GrumpyKit10/Wildfire-Detection-System/Documentation/Media/IMG_20230428_120932731.jpg

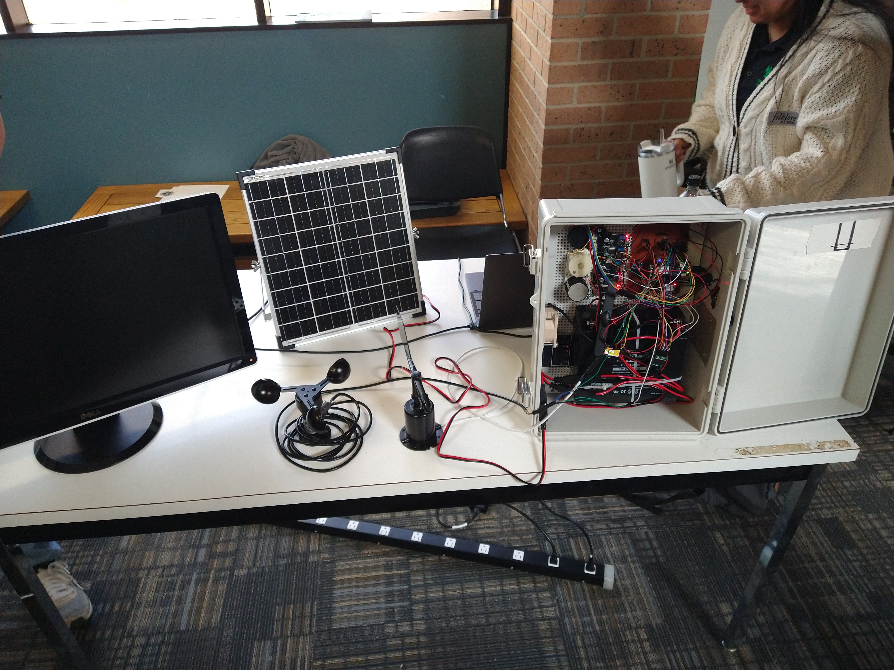
Documentation/Media/IMG_20230428_120932731.jpg
