GrumpyKit10/Wildfire-Detection-System/Documentation/Media/IMG_5393.jpg

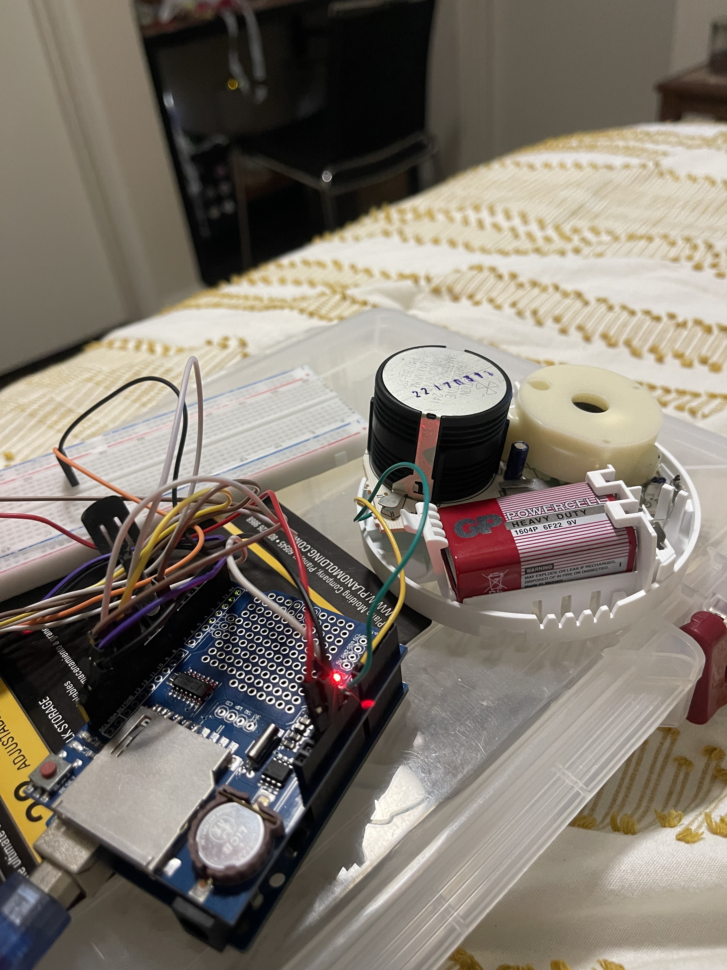
Documentation/Media/IMG_5393.jpg
