GrumpyKit10/Wildfire-Detection-System/Documentation/Media/20221214_185445.jpg

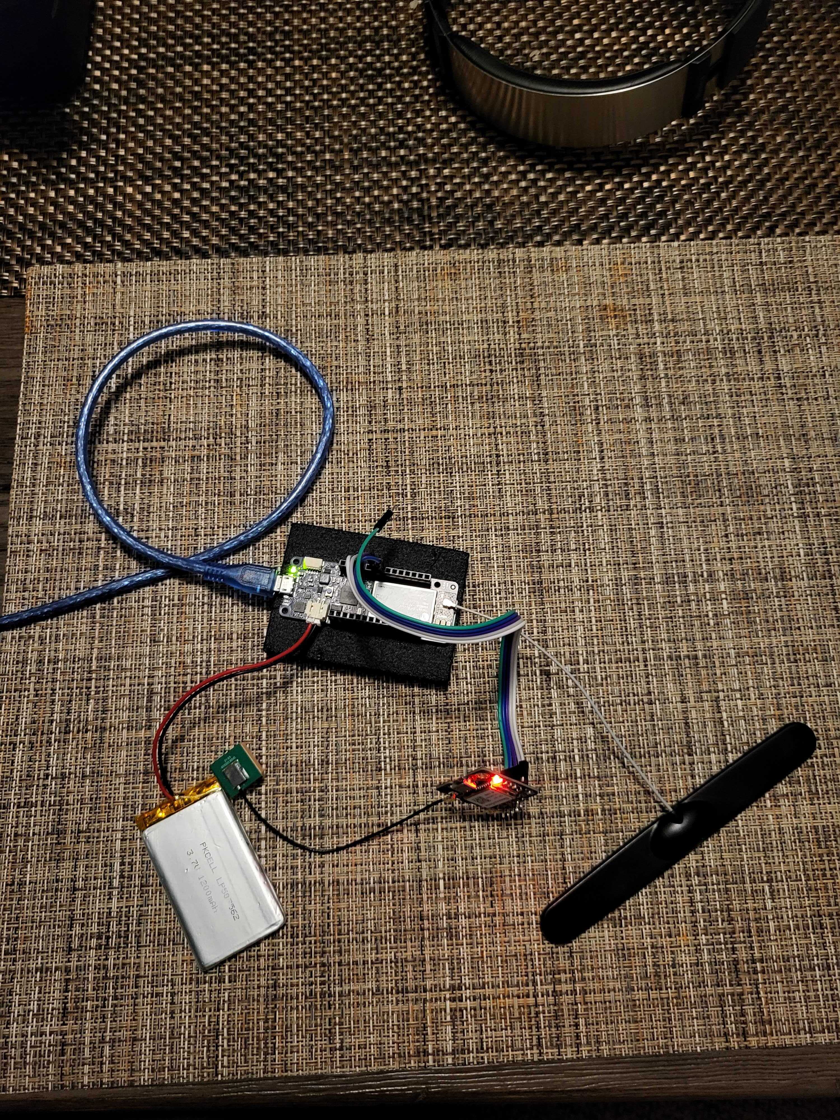
Documentation/Media/20221214_185445.jpg
