GrumpyKit10/Wildfire-Detection-System/Documentation/Media/IMG_5392.jpg

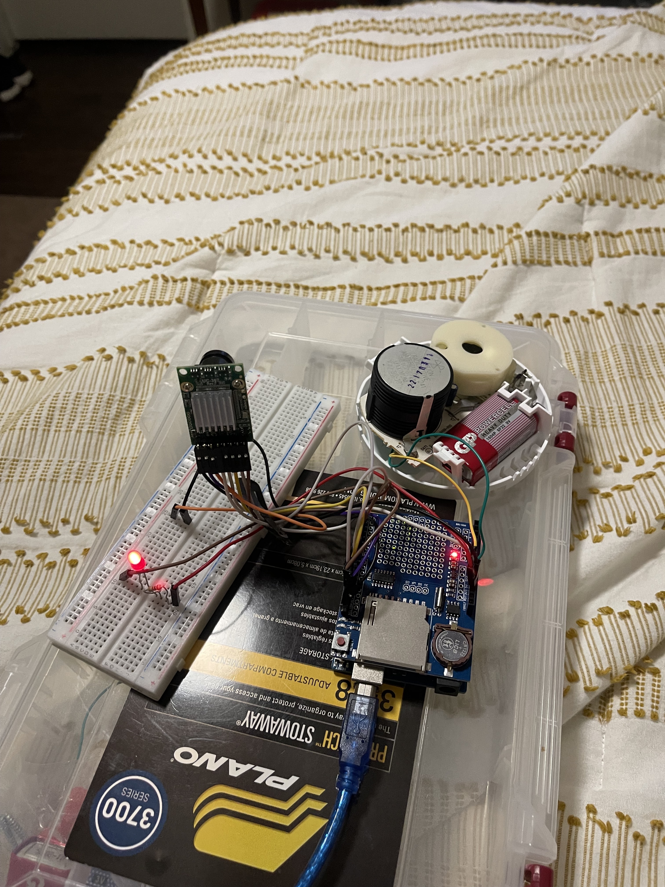
Documentation/Media/IMG_5392.jpg
