GrumpyKit10/Wildfire-Detection-System/Documentation/Media/IMG_20230406_163446074.jpg

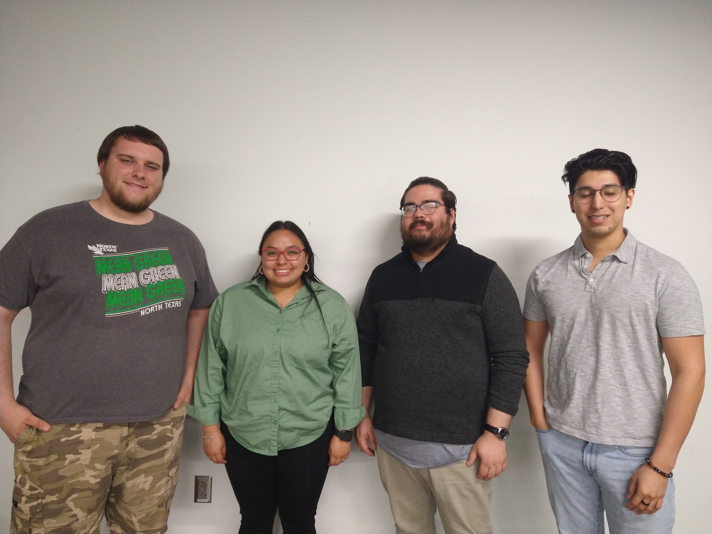
Documentation/Media/IMG_20230406_163446074.jpg
