GrumpyKit10/Wildfire-Detection-System/Documentation/Media/IMG_20230428_121048171_HDR.jpg

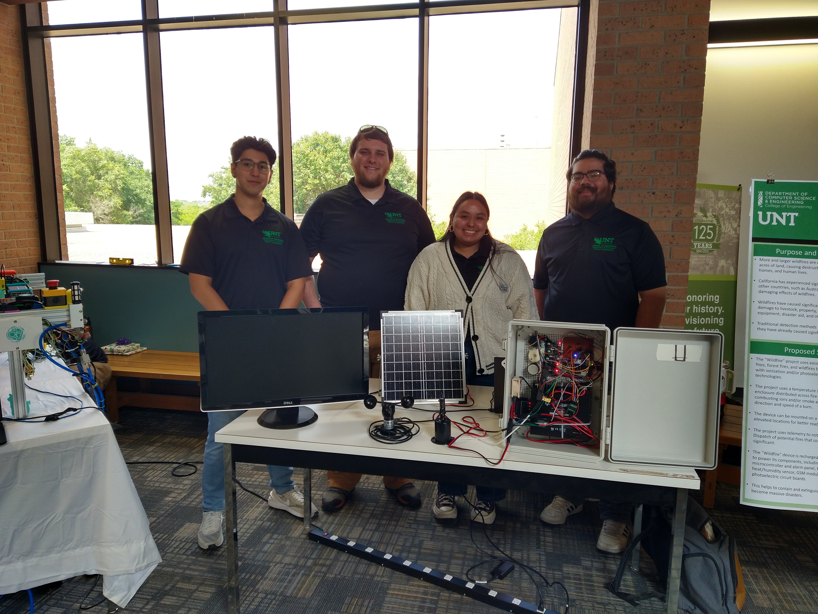
Documentation/Media/IMG_20230428_121048171_HDR.jpg
