GrumpyKit10/Wildfire-Detection-System/Documentation/Media/IMG_20230428_123631898.jpg

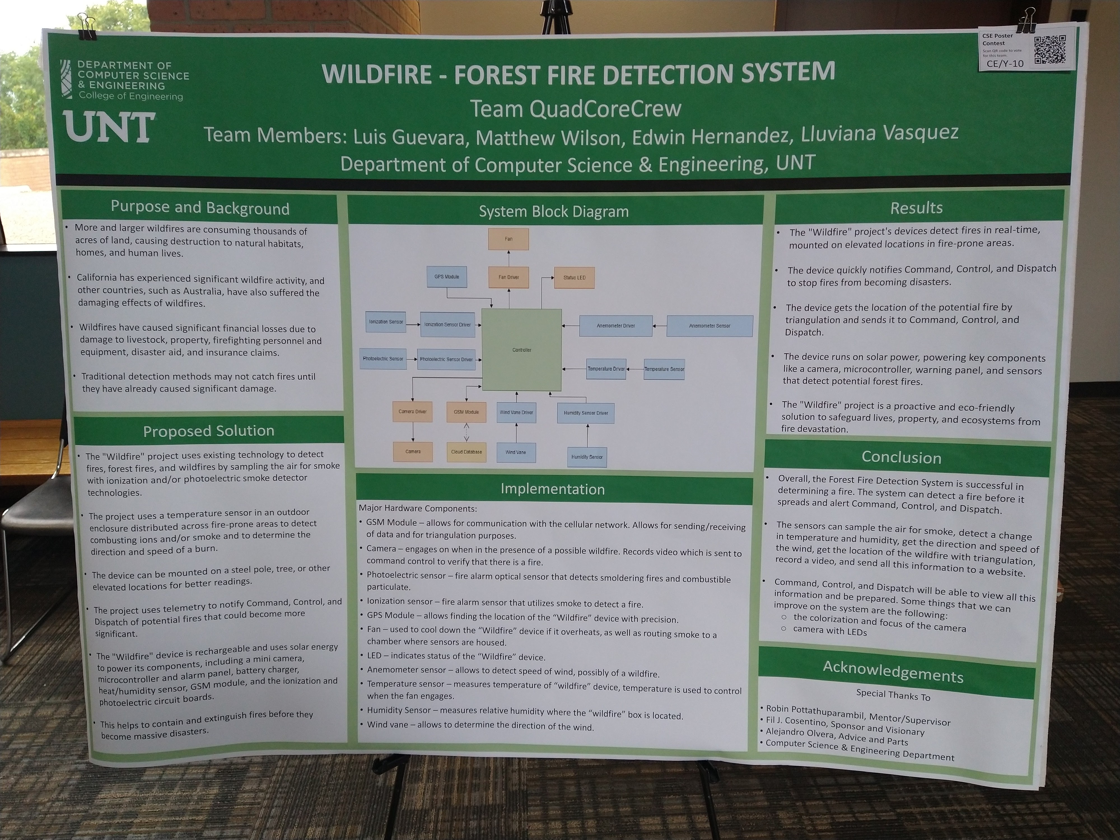
Documentation/Media/IMG_20230428_123631898.jpg
