GrumpyKit10/Wildfire-Detection-System/Documentation/Media/IMG_20230502_205920810.jpg

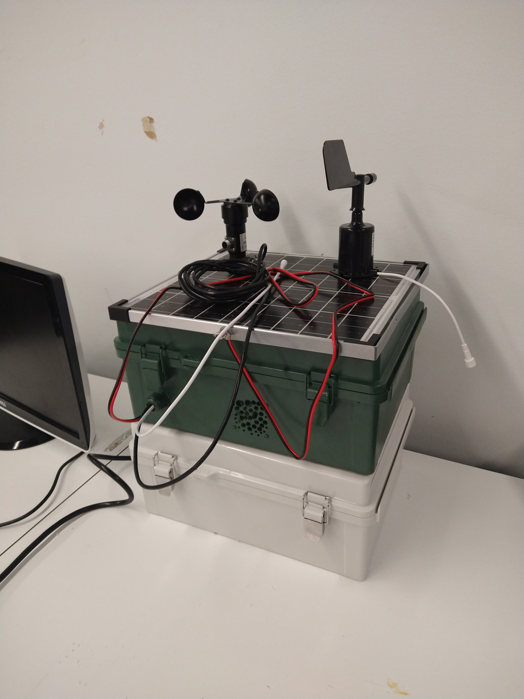
Documentation/Media/IMG_20230502_205920810.jpg
