GrumpyKit10/Wildfire-Detection-System/Documentation/Media/IMG_20230502_210135230.jpg

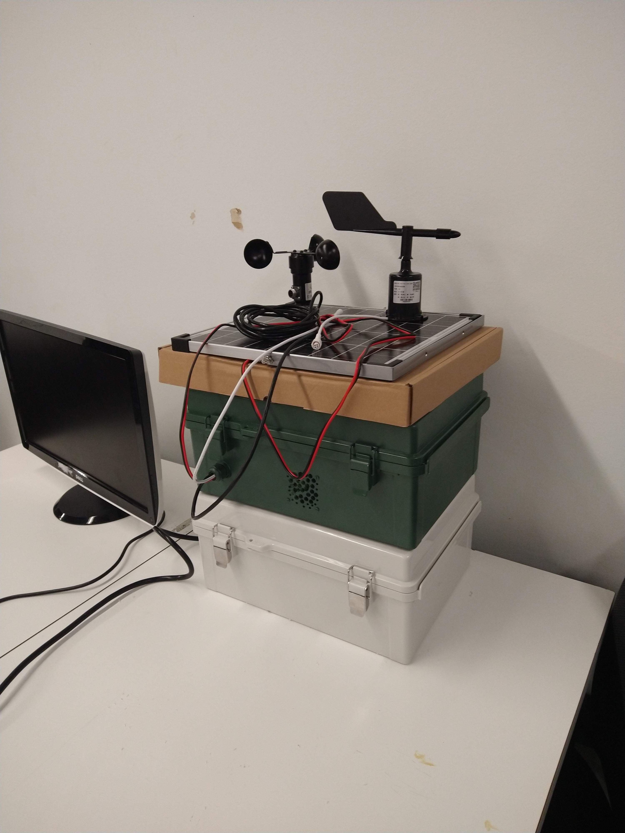
Documentation/Media/IMG_20230502_210135230.jpg
