GrumpyKit10/Wildfire-Detection-System/Documentation/Media/IMG_20230503_210256483.jpg

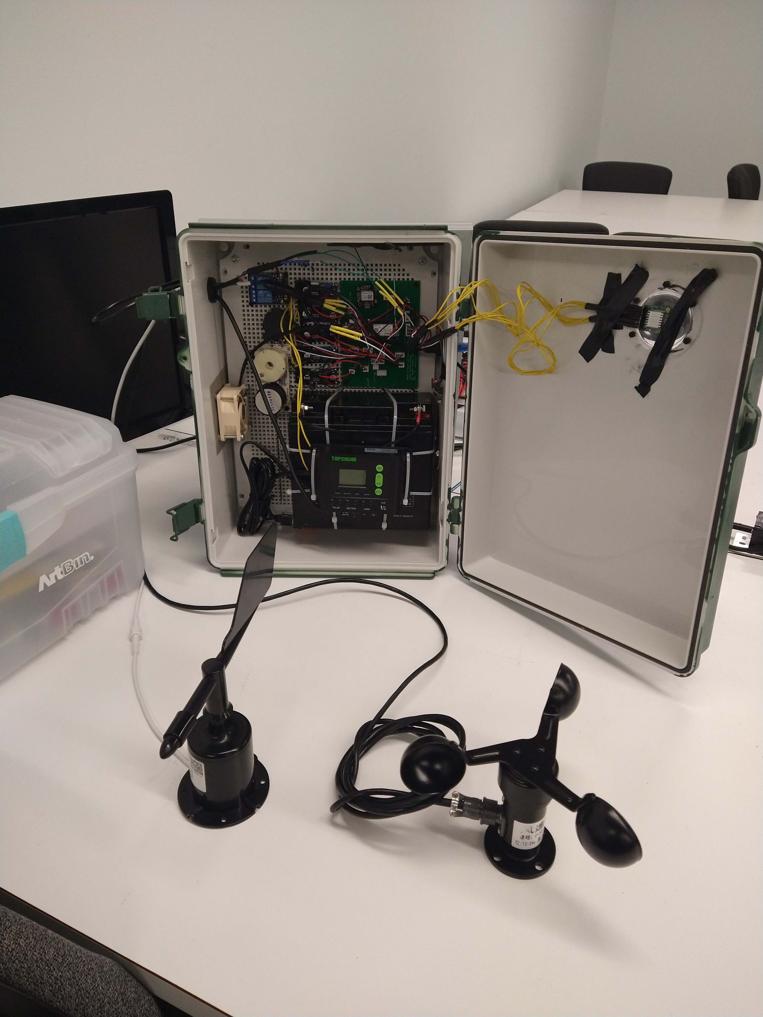
Documentation/Media/IMG_20230503_210256483.jpg
