GrumpyKit10/Wildfire-Detection-System/Documentation/Media/IMG_20230503_210301753.jpg

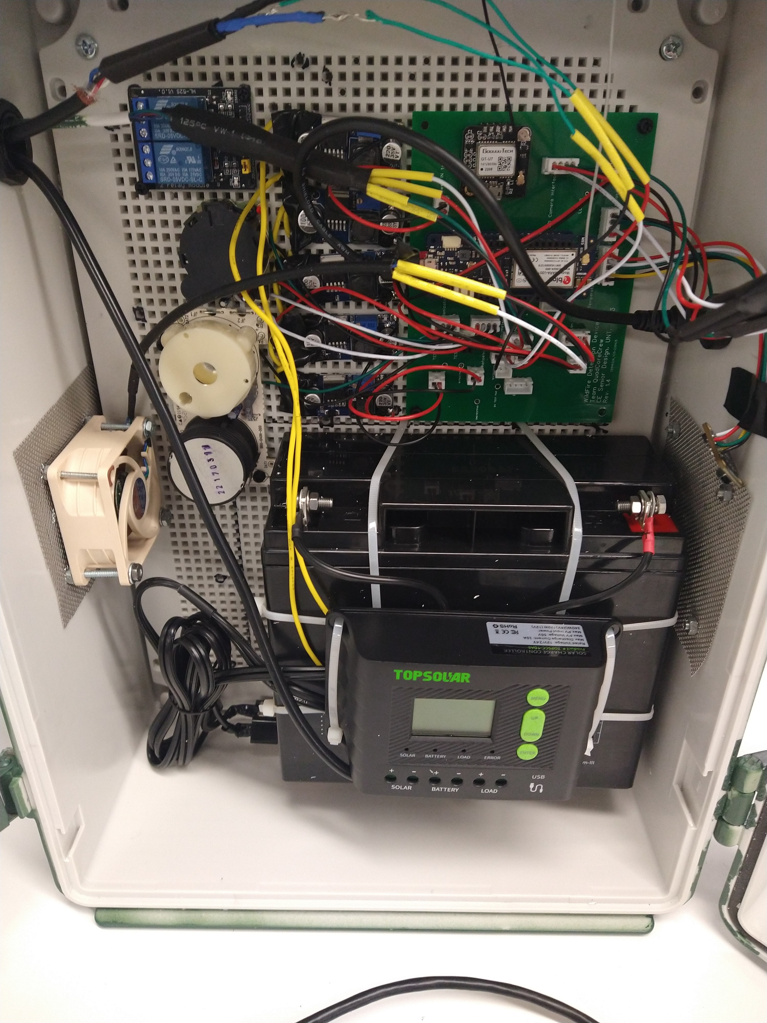
Documentation/Media/IMG_20230503_210301753.jpg
