GrumpyKit10/Wildfire-Detection-System/Documentation/Media/IMG_20230503_210322794.jpg

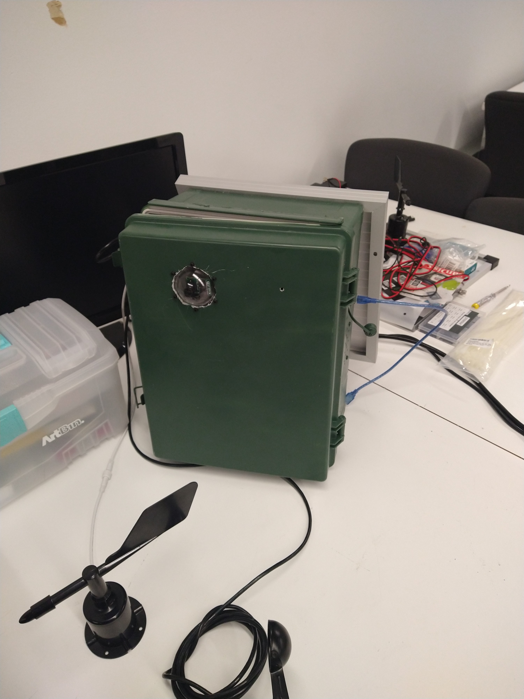
Documentation/Media/IMG_20230503_210322794.jpg
