GrumpyKit10/Wildfire-Detection-System/Documentation/Media/IMG_20230504_181027090_HDR.jpg

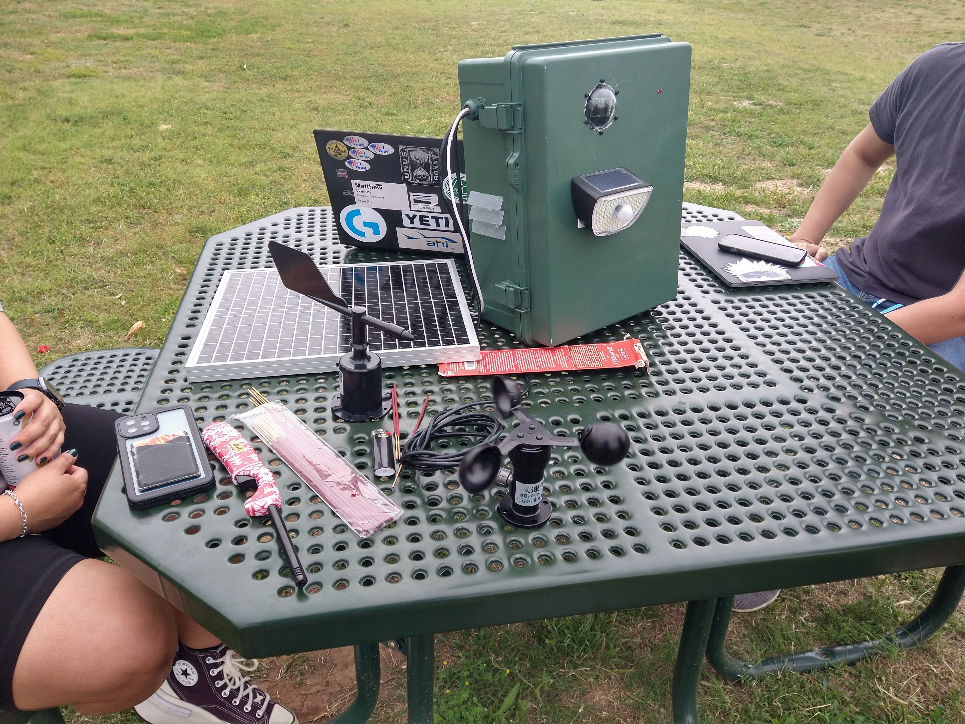
Documentation/Media/IMG_20230504_181027090_HDR.jpg
