GrumpyKit10/Wildfire-Detection-System/Documentation/Media/IMG_20230507_223427086.jpg

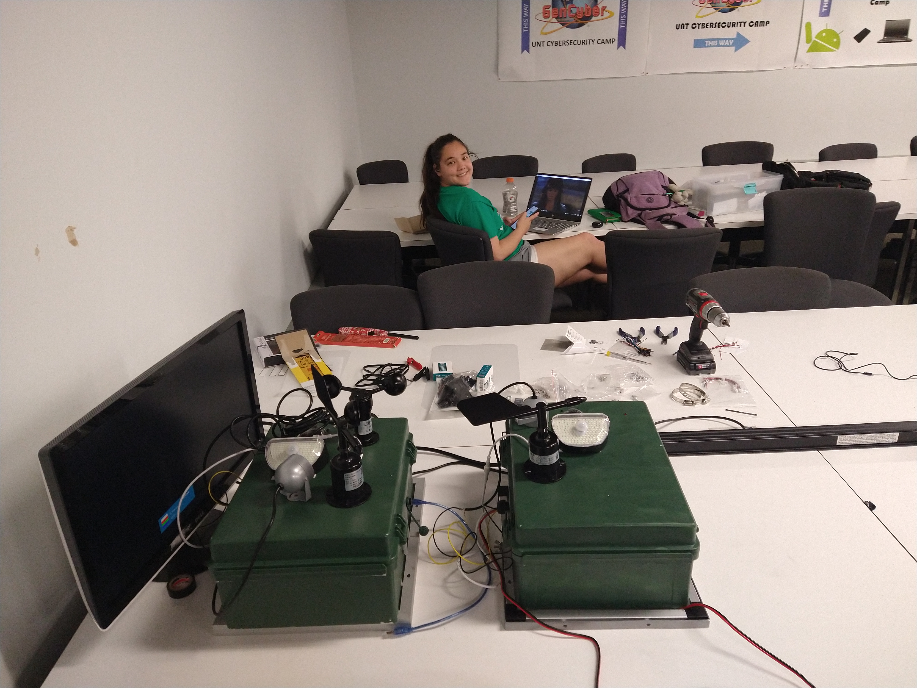
Documentation/Media/IMG_20230507_223427086.jpg
