GrumpyKit10/Wildfire-Detection-System/Documentation/Media/IMG_20230507_223429401.jpg

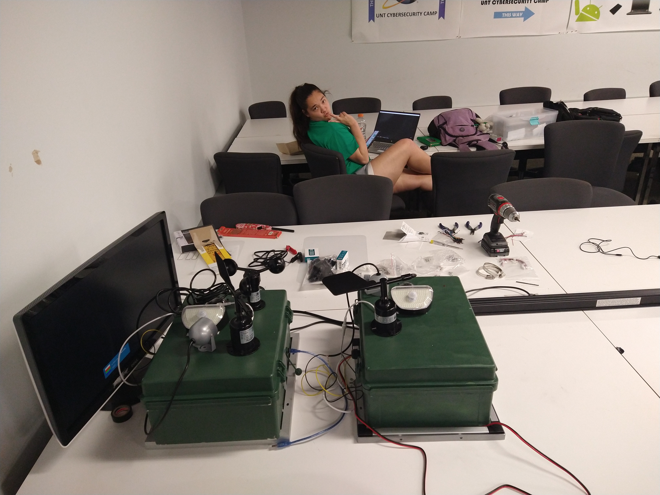
Documentation/Media/IMG_20230507_223429401.jpg
