GrumpyKit10/Wildfire-Detection-System/Documentation/Media/Screen Shot 2022-12-14 at 7.20.42 PM.png

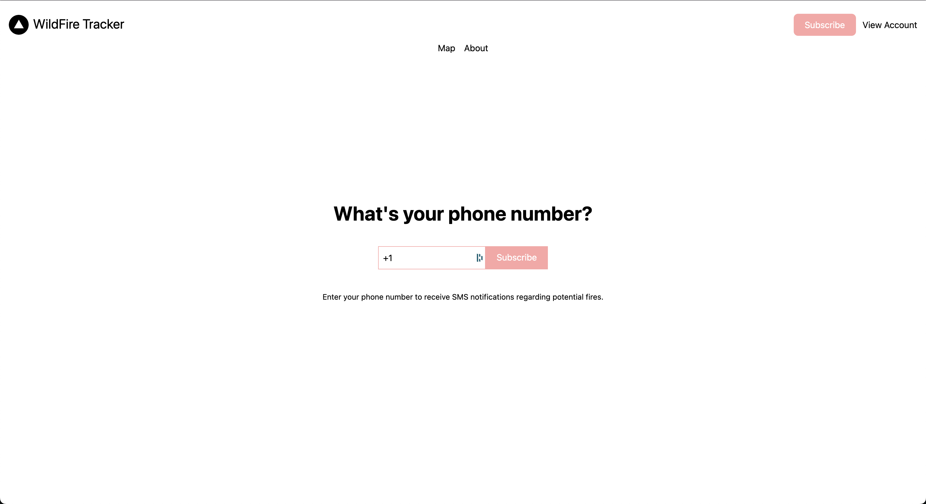
Documentation/Media/Screen Shot 2022-12-14 at 7.20.42 PM.png
